rFeijoo/tcc/README.md

# Trabalho de Conclusão de Curso

Monografia submetida ao curso de graduação em (Engenharia Eletrônica) da Universidade de Brasília, como requisito parcial para obtenção do Título de Bacharel em (Engenharia Eletrônica).

## Resumo

O aumento acelerado da demanda por energia elétrica em todo o mundo, associado a necessidade de diminuir a dependência por combustíveis fósseis, têm alavancado a busca por fontes de energia alternativas. Nos últimos anos, destaca-se o forte crescimento do setor solar fotovoltaico brasileiro, com sistemas conectados à rede, que chegou a crescer 216% em um período de três anos. Nesse contexto, este trabalho tem por objetivo principal o desenvolvimento de um sistema microcontrolado, voltado para o monitoramento e controle de String Box, se aproveitando do cenário promissor do setor.

## Diagrama de Blocos do Sistema

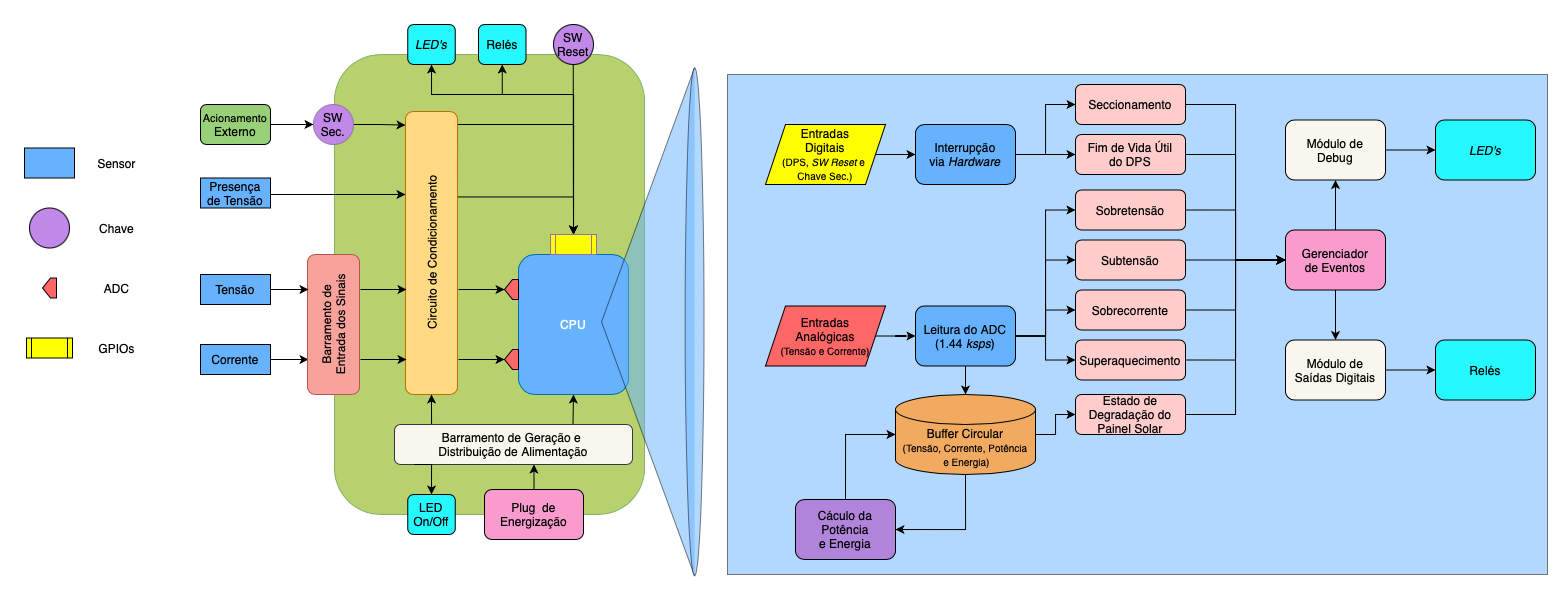
[picture p1: figuras/im1.png]
image info
