rFeijoo/tcc/hardware/BOM.xlsx

Bill Of Materials
Componente | Valor | Package | Qnt | Designador
Capacitor | 1nF/50V | Cerâmico (RAD-0.2) | 6 | C2, C3, C4, C8, C9, C10
Capacitor | 10nF/50V | Cerâmico (RAD-0.2) | 4 | C1, C5, C7, C11
Capacitor | 100nF/50V | Cerâmico (RAD-0.2) | 7 | C6, C12, C14, C15, C17, C20, C22
Capacitor | 10uF/50V | Eletrolítico (D6.3XF2.5) | 1 | C21
Capacitor | 100uF/25V | Eletrolítico (D6.3XF2.5) | 4 | C13, C16, C18, C19
Resistor | 100Ω | PTH-1/4W | 4 | R16, R17, R18, R19
Resistor | 120Ω | PTH-1/4W (1%) | 1 | R3
Resistor | 150Ω | PTH-1/4W (1%) | 1 | R9
Resistor | 220Ω | PTH-1/4W | 3 | R21, R23, R34
Resistor | 1.2KΩ | PTH-1/4W | 2 | R27, R28
Resistor | 4.7KΩ | PTH-1/4W | 4 | R5, R7, R11, R13
Resistor | 10KΩ | PTH-1/4W | 11 | R4, R6, R10, R12, R15, R20, R22, R24, R25, R26, R29
Resistor | 100KΩ | PTH-1/4W | 2 | R8, R14
Resistor | 100KΩ | PTH-3W | 2 | R1, R2
Diodo Retificador | 1N4007 | DO-41 | 6 | D2, D3, D4, D5, D6, D7
Diodo TVS | P6KE6.8A | DO-15 | 1 | D1
Diodo Zener | 1N4728 (3.3V) | DO-41 | 2 | ZD1, ZD2
LED | Amarelo | PTH-5mm | 3 | LED1, LED2, LED3
LED | Vermelho | PTH-5mm | 2 | LED4, LED5
LED | Verde | PTH-5mm | 3 | LED6, LED7, LED10
Relé | 120VAC 10A | JQC-3F-C 5V | 2 | K1, K2
TBJ | 2N2222 | TO-92 | 2 | Q1, Q2
Regulador de Tensão | 7812 | TO-220 | 1 | U6
Regulador de Tensão | 7912 | TO-220 | 1 | U7
Tansformador | 15+15VAC |  | 1 | IO5
AmpOp | LM358 | DIP8 | 1 | U3
Transdutor de Tensão | LV 20-P |  | 1 | U1
Transdutor de Corrente | LA 55-P |  | 1 | U2
Microcontrolador | STM32 NUCLEO-G474RE |  | 1 | MCU1
Dissipador de Calor | 34,5X12,5X20mm | DN322 | 2 | U6, U7
Conector | KRE 2P | KRE | 1 | IO1
Conector | KRE 3P | KRE | 6 | IO0, IO2, IO3, IO4, IO5, IO6
Conector | Male Header | Header 2x1 | 1 | JP1
Conector | Female Header | MKBL02 | 1 | JP1
Conector | Female Header | Header 2x19 | 2 | MCU1
Conector | Female Header | Header 2x1 | 2 | MCU1
Conector | Female Header | Header 1x6 | 1 | MCU1
Conector | Female Header | Header 1x8 | 2 | MCU1
Conector | Female Header | Header 1x10 | 1 | MCU1
