rFeijoo/tcc/hardware/PCB_View-Controller.pdf

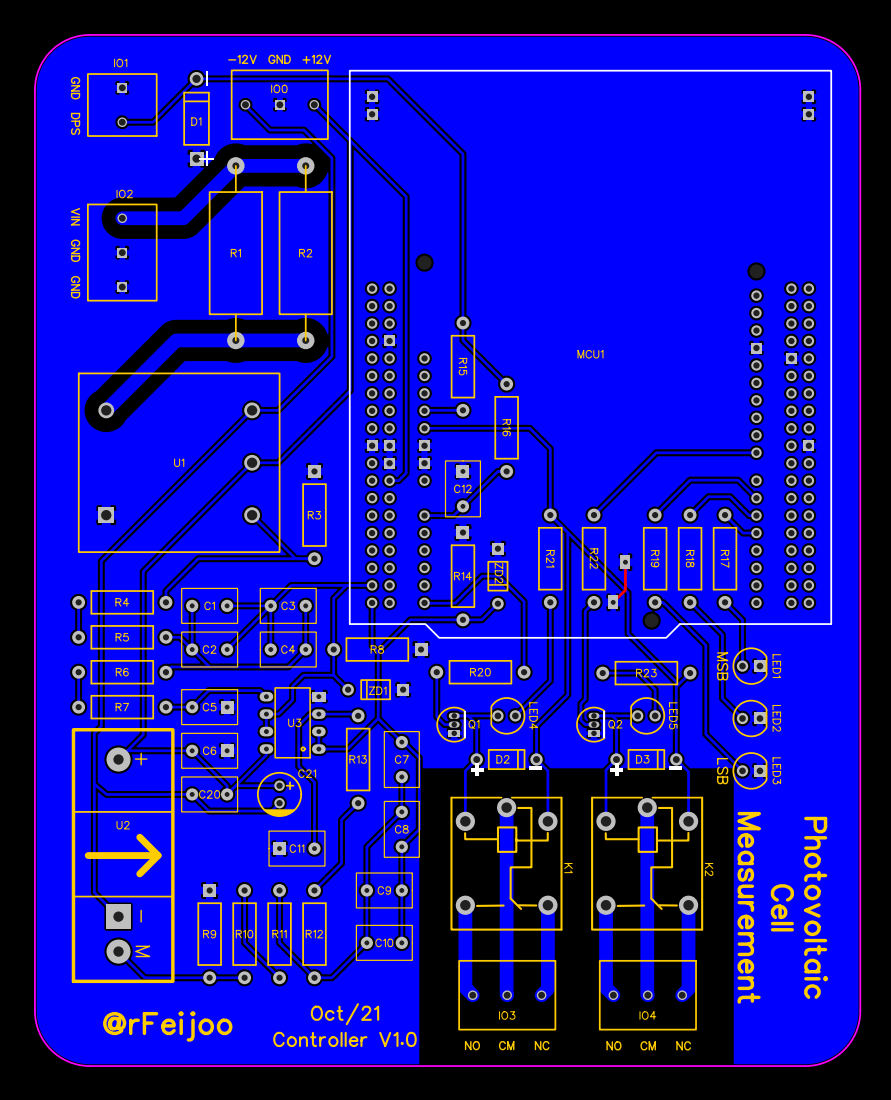
[picture p6: page 1]
