rFeijoo/tcc/hardware/PCB_View-Power_Supply.pdf

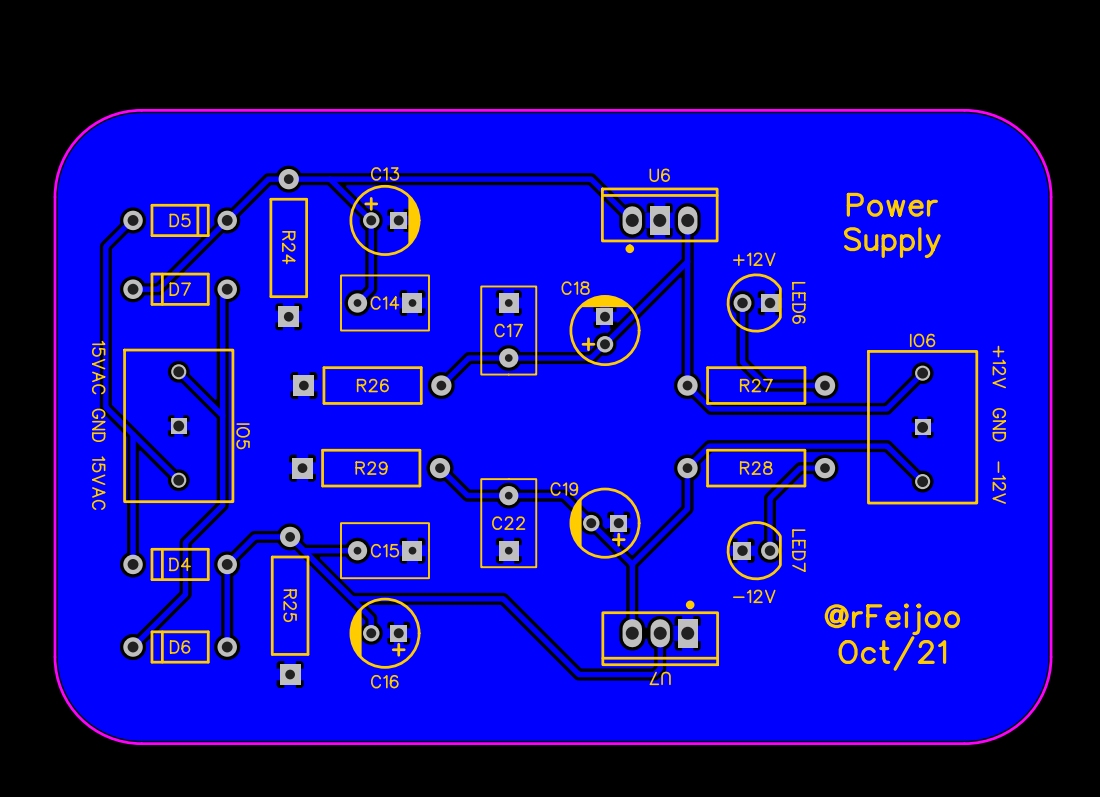
[picture p7: page 1]
