rFeijoo/tcc/hardware/SCH-Power_Supply.pdf

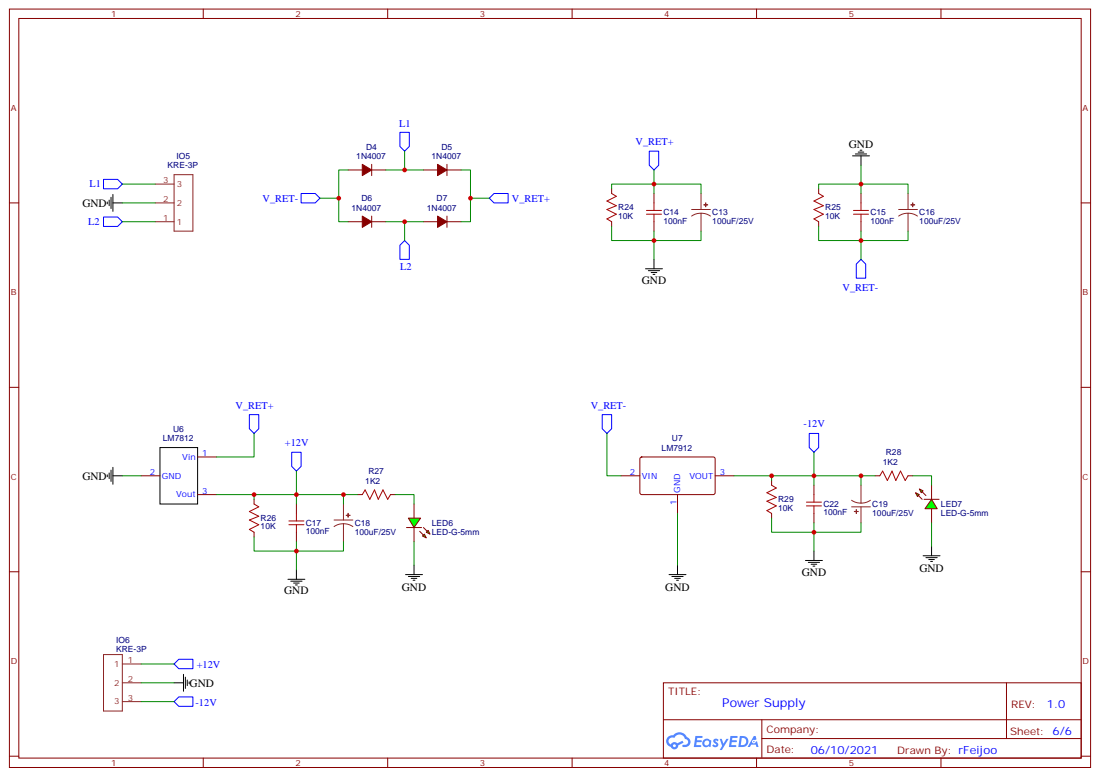
[picture p8: page 1]
