rFeijoo/tcc/hardware/SCH-Relays.pdf

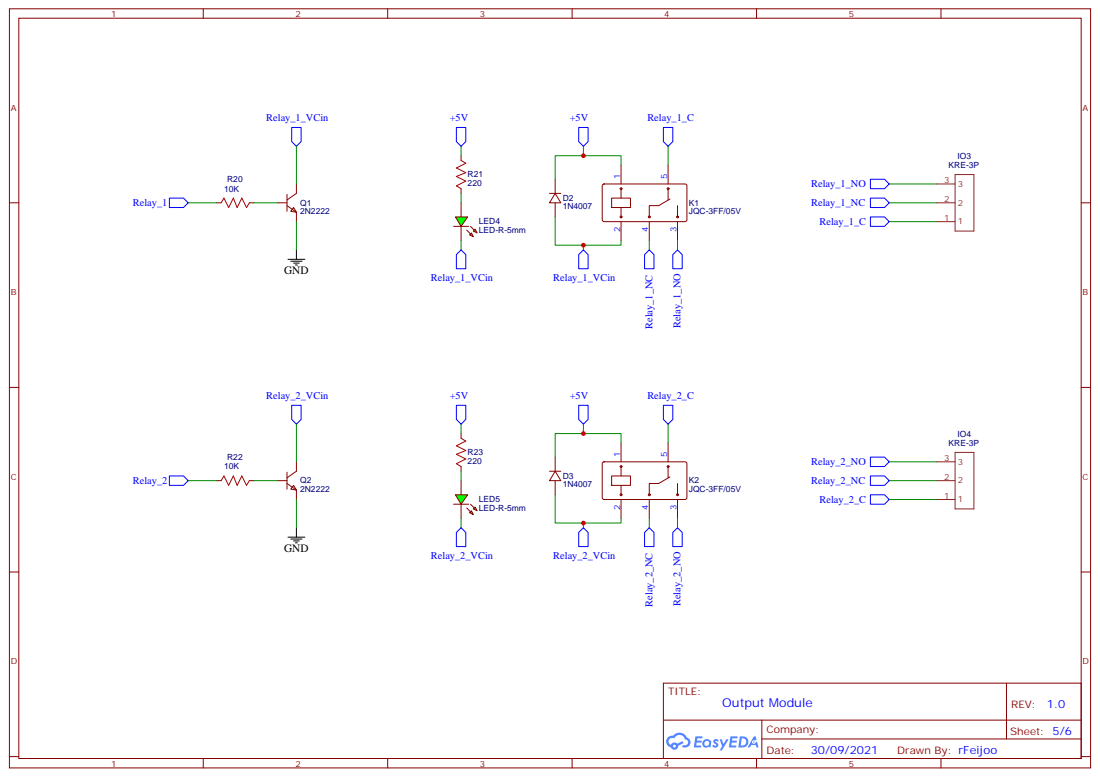
[picture p9: page 1]
