rFeijoo/tcc/hardware/SCH-Sensors.pdf

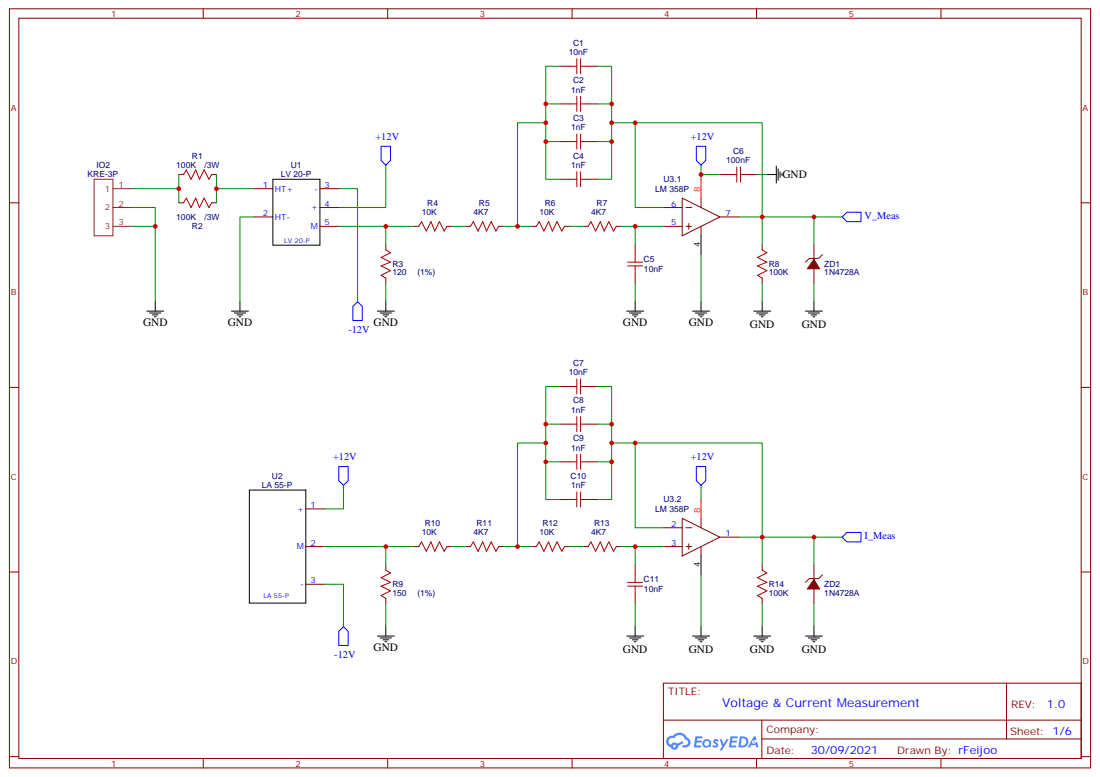
[picture p10: page 1]
