rFeijoo/tcc/hardware/SCH-Switches.pdf

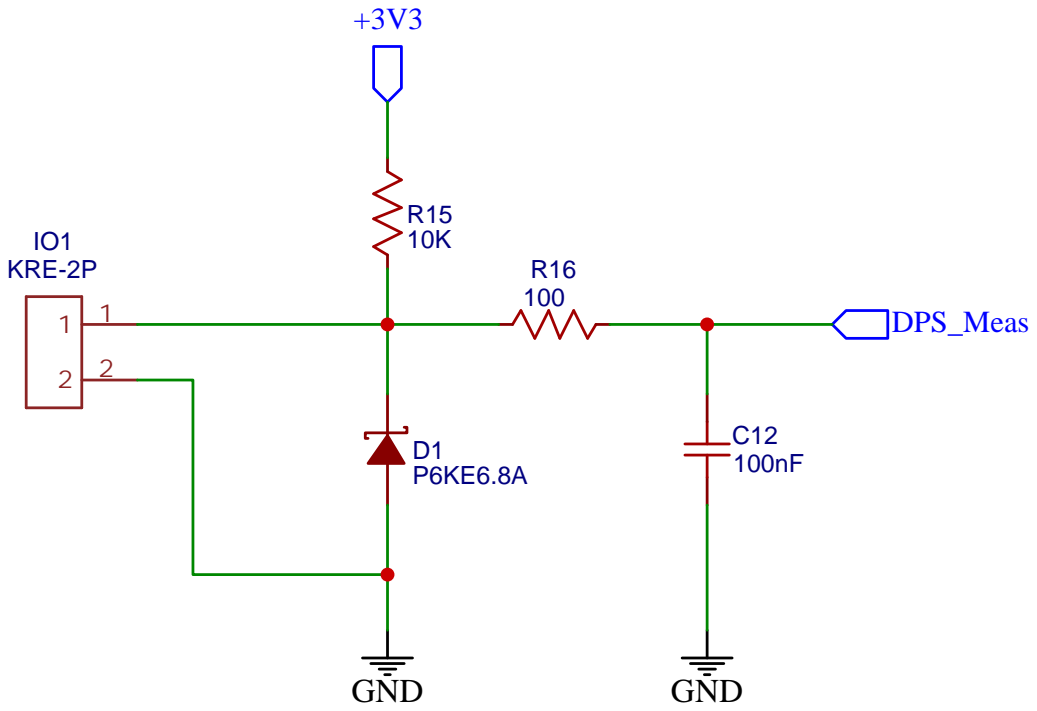
[picture p11: page 1]
