rFeijoo/tcc/hardware/SCH-uC.pdf

IO0 1

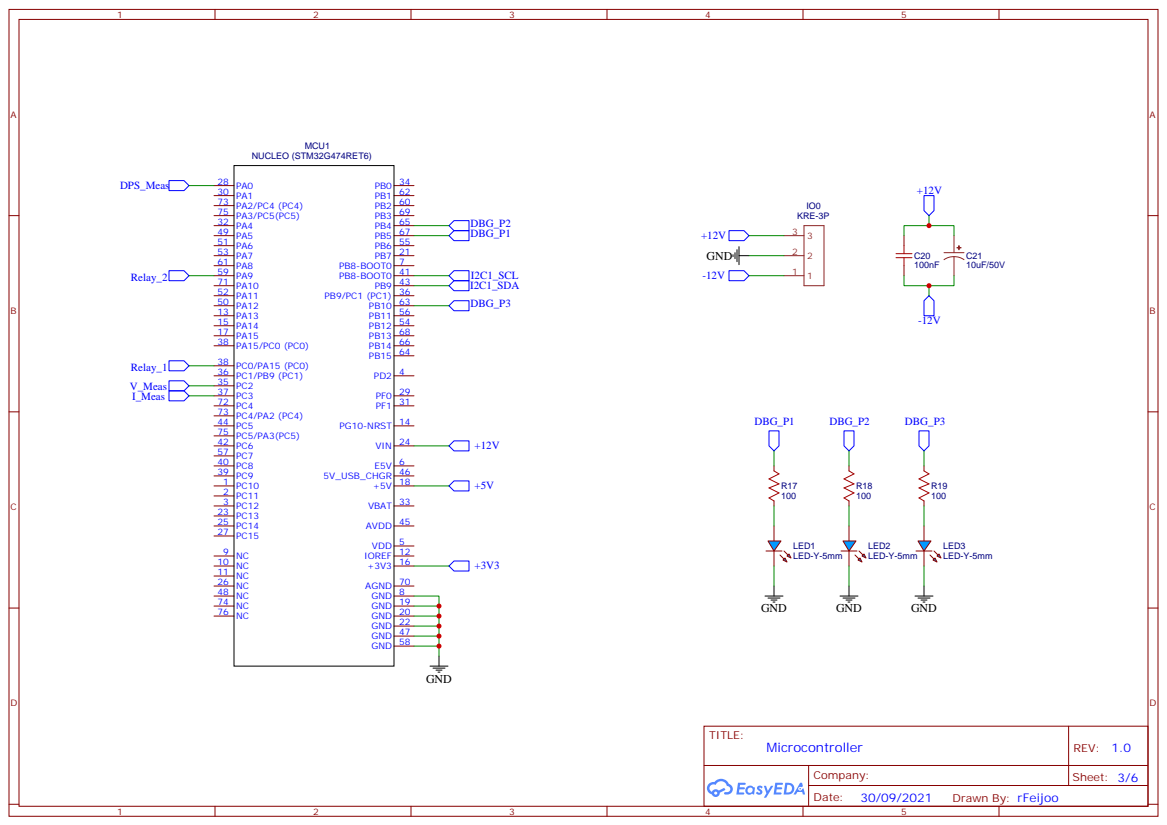
[picture p12: page 1]
