rFeijoo/tcc/firmware/Core/Src/main.c

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
/* Includes ------------------------------------------------------------------*/
#include "main.h"
#include "adc.h"
#include "tim.h"
#include "gpio.h"

/* USER CODE BEGIN Includes */
#include <stdio.h>
#include "meas.h"
#include "objects_def.h"
#include "events.h"
/* USER CODE END Includes */


void SystemClock_Config(void);
/* USER CODE BEGIN 0 */
int _write(int file, char *ptr, int len)
{
	for (int i=0 ; i<len ; i++)
		ITM_SendChar((*ptr++));

	return (len);
}
/* USER CODE END 0 */

/**
  * @brief  The application entry point.
  * @retval int
  */
int main(void)
{
  /* MCU Configuration--------------------------------------------------------*/

  /* Reset of all peripherals, Initializes the Flash interface and the Systick. */
  HAL_Init();

  /* Configure the system clock */
  SystemClock_Config();

  /* Initialize all configured peripherals */
  MX_GPIO_Init();
  MX_TIM1_Init();
  MX_ADC1_Init();
  MX_ADC2_Init();
  MX_ADC5_Init();
  MX_TIM2_Init();
  /* USER CODE BEGIN 2 */
  printf("-- Starting System's Configuration\n\n");

  objects_def_init();

  HAL_ADCEx_Calibration_Start(&hadc5, ADC_SINGLE_ENDED);

  HAL_TIM_Base_Start_IT(&htim1);
  HAL_TIM_Base_Start_IT(&htim2);

  printf("-- End of System's Configuration\n");
  /* USER CODE END 2 */

  /* Infinite loop */
  /* USER CODE BEGIN WHILE */
  while (1)
  {
	objects_def_loop();
    /* USER CODE END WHILE */

    /* USER CODE BEGIN 3 */
  }
  /* USER CODE END 3 */
}

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
