rFeijoo/tcc/firmware/Core/Inc/main.h

#define CELL_1_BTN_Pin GPIO_PIN_13
#define CELL_1_BTN_GPIO_Port GPIOC
#define CELL_1_BTN_EXTI_IRQn EXTI15_10_IRQn
#define CELL_1_OUT_NEG_Pin GPIO_PIN_0
#define CELL_1_OUT_NEG_GPIO_Port GPIOC
#define CELL_1_VOLTAGE_Pin GPIO_PIN_2
#define CELL_1_VOLTAGE_GPIO_Port GPIOC
#define CELL_1_CURRENT_Pin GPIO_PIN_3
#define CELL_1_CURRENT_GPIO_Port GPIOC
#define CELL_1_DPS_Pin GPIO_PIN_0
#define CELL_1_DPS_GPIO_Port GPIOA
#define CELL_1_DPS_EXTI_IRQn EXTI0_IRQn
#define CELL_1_BUILTIN_LED_Pin GPIO_PIN_5
#define CELL_1_BUILTIN_LED_GPIO_Port GPIOA
#define CELL_1_DBG3_Pin GPIO_PIN_10
#define CELL_1_DBG3_GPIO_Port GPIOB
#define CELL_1_OUT_POS_Pin GPIO_PIN_9
#define CELL_1_OUT_POS_GPIO_Port GPIOA
#define T_SWDIO_Pin GPIO_PIN_13
#define T_SWDIO_GPIO_Port GPIOA
#define T_SWCLK_Pin GPIO_PIN_14
#define T_SWCLK_GPIO_Port GPIOA
#define CELL_1_DBG2_Pin GPIO_PIN_4
#define CELL_1_DBG2_GPIO_Port GPIOB
#define CELL_1_DBG1_Pin GPIO_PIN_5
#define CELL_1_DBG1_GPIO_Port GPIOB
#define VCC					3.3
#define ADC_RES_BITS		4095.0
#define WORD_LENGTH			32
#define HALF_WORD_LENGTH	16
#define LSB_WORD_BIT_MASK	0xFFFF
