rFeijoo/tcc/(commit log)

2021-09-06 Added Voltage & Current sample routines, aggregation protocol and power & energy calculation
2021-09-14 Added support to internal temperature sensor
2021-09-14 Added debugger rountine (LED's output)
2021-09-29 Added hysteresis to measurements in order to prevent relay bounces
    [events.c, events.h, firmware.ioc, main.h, meas.c, meas.h, objects_def.c]
2021-10-05 Remap IOs for PCB design
2021-10-06 Added Power Supply Layout V1.0
2021-10-06 Update Power Supply Layout V1.0
2021-10-06 Added circuit's schematic
2021-10-06 Remap IOs for PCB design update
2021-10-06 Added system's BOM
    [BOM.xlsx]
2021-10-06 Added Debugger's PCB design
2021-10-06 Added connector P4
2021-10-06 Added Unregulated Main Power Supply (+30VDC output)
2021-10-06 Update BOM
    [BOM.xlsx]
2021-10-09 Divided into Transformer & LM2576 sub-circuits
    [BOM-LM2576.xlsx, BOM-Transformer.xlsx, BOM.xlsx]
2021-10-17 Updated LV 20-P footprint
2021-10-17 Updated I2C Converter footprint
2021-10-17 Updated Schematics
2021-10-17 Updated firmare after firsts PCB tests
2021-10-21 Final version hardware project
    [BOM-LM2576.xlsx, BOM.xlsx]
2021-11-02 last commit before PR
    [BOM.xlsx]
